Explore-Space/CAD_000/README.md

# 机械设计课程设计

## 设计要求

>（待完善）

## 文件说明

### 主要

>装配图
>
>>装配图A1.dwg
>>
>>装配图A1.bak

>零件图
>
>>大齿轮_A3.dwg
>>
>>大齿轮_A3.bak
>
>>输出轴_A3.dwg
>>
>>输出轴_A3.bak

>设计说明书.docx

### 附件

>（待完善）
