Explore-Space/CAD_000/设计说明书.docx

机械设计课程设计

计算说明书

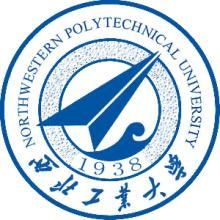
[picture p1: figure]

专业班级： 02031702班

学生姓名： 安宇欣

指导老师： 苏华

目录

一、设计任务

1.1设计题目

设计一个带式输送机传动装置

工作简图如下：

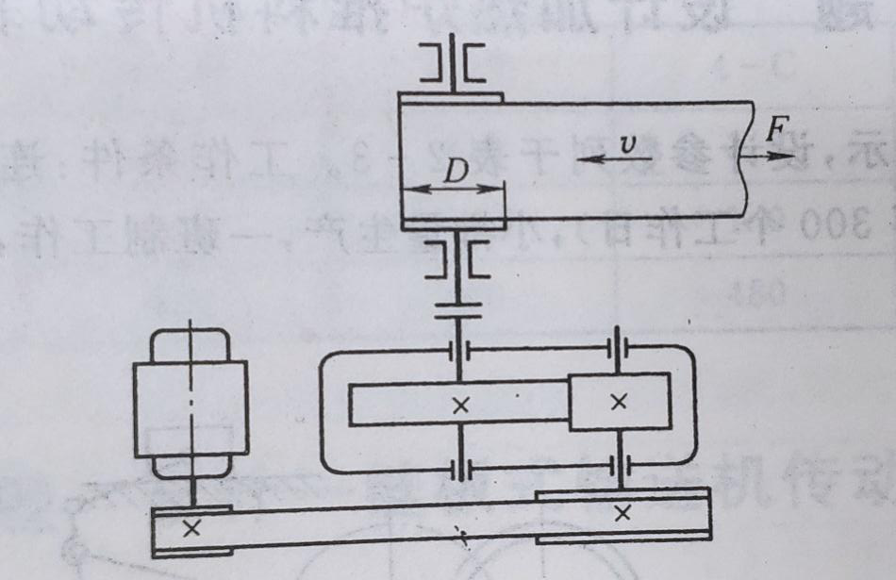
[picture p2: figure]

1.2工作条件

连续单向运转，载荷平稳，空载启动，使用期10年（每年300个工作日），小批量生产，两班制工作，输送机工作轴转速允许误差为±5%。带式输送机的传动效率为0.96。

1.3设计参数

输送带的牵引力为1.5kN，输送带的速度为1.7m/s，输送带滚筒的直径为260 mm。

## 二、电动机选择

2.1 工作机所需功率

P_w =(F_w v_w)/(1000η_w)=1500×1.7/(1000×0.96)=2.6563kW

2.2 电动机至工作机的总效率η

V带传动效率 η_带 =0.96

第一对滚动球轴承效率 η_(轴承1) =0.99

闭式七级精度锥齿轮传动 η_(齿轮) =0.98

第二对滚动球轴承 η_(轴承2) =0.99

联轴器效率 η_(联轴器) =0.99

第三对滚动球轴承 η_(轴承3) =0.99

η=η_带 ×η_(轴承1) ×η_(齿轮) ×η_(轴承2) ×η_(联轴器) ×η_(轴承3) =0.96×0.99×0.97×0.99×0.99×0.99=0.9037

2.3 所需电动机的输出功率 P_d

P_d =P_w /η=2.6563/0.9037=2.9394kW

2.4 电动机的额定功率

由 P_m ≥P_d 选电动机型号，选择电动机型号为Y132S-6，查表得额定功率 P_m =3kW ，满载转速为 n_m =960r/min

根据计算数据参考《机械设计课程设计》第二版P192提供参数，其参数如表1所示

表1
额定功率/kW | 满载转速/（r/min） | 堵转转矩/ 额定转矩 | 最大转矩/ 额定转矩 | 质量/kg
3 | 960 | 2.0 | 2.2 | 63

## 三、传动比分配

总传动比 i=(n_m)/(n_w)=960/124.8754=7.6877

带传动 i_带 =2 ，

则齿轮传动 i_齿 =i/(i_带)=7.6877/2=3.8439

验算工作速度误差 Δv=(v_理 －v_实)/(v_理)×100%=(124.8754-130.8732)/124.8754≤±5%

传动比分配满足要求

即取一级齿轮减速器传动比为3.8439传动比，带传动比为2

## 四、传动参数的计算

4.1各轴的转速

电动机转速： n_m ＝960r/min

减速器输入轴转速： n_1 =(n_m)/(i_带)=960/2=480r/min

减速器输出轴转速： n_2 =(n_1)/(i_齿)=480/3.8439=124.87r/min

链轮轴转速： n_3 ＝n_2 ＝124.87r/min

4.2各轴的输入功率

电动机轴的输入功率: P_0 =P_d =3kW

减速器输入轴功率： P_1 =P_0 ×η_带 =2.88kW

减速器输出轴功率： P_2 =P_1 ×η_(轴承2) ×η_齿 ×η_(轴承3) =2.766×0.99×0.98×0.99=2.766kW

滚筒轴功率： P_3 =P_2 ×η_(联轴器) ×η_(轴承1) =2.766×0.99×0.99=2.711kW

4.3各轴的输入扭矩

电动机输入转矩: T_0 =9550×(P_0)/(n_0)=9550×3/960=29.844N/m

减速器输入轴输入转矩: T_1 =9550×(P_1)/(n_1)=9550×2.88/480=57.3N/m

减速器输出轴输出转矩: T_2 =9550×(P_2)/(n_2)=9550×2.766/124.87=211.542N/m

链板轴输入转矩: T_3 =9550×(P_3)/(n_3)=9550×2.711/124.87=207.336N/m

## 五、V带传动设计计算

5.1选择V带类型

此减速器为轻负载运输机，查《机械设计教程》得其工作情况系数KA=1.1，

故计算功率： P_(ca) =K_A P_m =1.2×3=3.3kW

转速： n_1 =960r/min

根据功率及转速，由《机械设计教程》第三版P74图6.10得：选用A型普通V带。

5.2确定带轮基准直径

由《机械设计教程》第三版P74表6.8、6.9和图6.10得，取小带轮的基准直径为 d_(d1) =100mm 。

则大带轮的基准直径为

d_(d2) =i_d d_(d1) =2×100=200mm

由《机械设计教程》第三版P74表6.9得，取大带轮直径为 d_(d2) =200mm

5.3验算带速

v=(πd_(d1) n_1)/(60×1000)=(π×100×960)/(60×1000)=5.027m/s<30m/s ，略大于5m/s，带速合适。

5.4初定中心距

0.7(d_(d1) +d_(d2) )≤a_0 ≤2(d_(d1) +d_(d2) )

即 210≤a_0 ≤600 ，取 a_0 =400mm 。

5.5确定带的基准长度

L_(d0) =2a_0 +π/2(d_(d1) +d_(d2) )+((d_(d2) -d_(d1) )^2)/(4a_0) =2×400+π/2×(100+200)+((200-100)^2)/(4×400)

=1271.30mm

查表得： L_d =1430mm 。

5.6确定实际中心距

a=a_0 +((L_d -L_(d0) ))/2=400+(1430-1271.30)/2=479.349mm

安装时所需最小中心距：

ad_(min) =a-0.015L_d =457.899mm

张紧或弥补伸长所需最大中心距：

ad_(max) =a+0.015L_d =500.799mm

5.7验算小带轮上的包角 α_1

α_1 =180°-(d_(d2) -d_(d1))/a×57.3°=180°-(200-100)/479.349×57.3°=168.046°

α_1 ≥120° 包角合适。

5.8计算单根V带的基本额定功率

已知 d_(d1) =100mm ， n_1 =960r/min ，查表得， P_0 =0.95kW 。

5.9计算单根V带的额定功率

传动比 i=2 ，查表得 ΔP_0 =0.11kW 。

包角 α_1 =168.046° ，查表得 K_α =0.97 。

带长 L_d =1430mm ，查表得 K_L =0.96 。

计算单根V带的额定功率：

P_r =(P_0 +ΔP_0 )K_L K_α =(0.95+0.11)×0.96×0.97=0.987kW

5.10计算带的根数

z=(P_(ca))/(P_r)=3.3/0.987=3.3434 ，取四根V带。

5.11计算单根V带的初拉力 F_0

由《机械设计教程》，A型V带的单位长度质量q=0.105kg/m。所以单根V带的初拉力F0为

F_0 =500×((2.5-K_α )P_(ca))/(K_α zv)+qv^2 =500×((2.5-0.97)×3.3)/(0.97×4×5.027)+0.105×5.027^2 =132.083N

5.12计算压轴力

其压轴力为：

F_P =2zF_0 sin(α_1)/2=2×4×132.083sin(168.046°)/2=1050.920N

## 六、闭式斜齿圆柱齿轮传动计算

6.1选定齿轮材料、齿数及齿宽系数

6.1.1选择材料如下:

小齿轮材料：40Cr，调质HBS1=250；大齿轮材料：45钢，调质HBS2=210；HBS1-HBS2=40；

6.1.2选齿数

小齿轮齿数选为 z_1 =27 ，大齿轮齿数 z_2 =27×3.8439=103.79 ，圆整为104

实际齿数比3.852，误差0.207%，可用

6.1.3选齿宽系数

由表8.4选定齿宽系数： φ_d =1.0

6.1.4初选螺旋角 β=15°

6.1.5计算几何参数

法面压力角： α_n =20°

tanα_t =(tanα_n)/(cosβ)=(tan20°)/(cos15°)=0.3768, α_t =20.6469°=20°38'49''

sinβ_b =sinβcosα_n =sin15°cos20°=0.2432

β_b =14.0761°=14°4'34''

ε_α =1/(2πcosα_t)[√((z_1 +2cosβ)^2 -(z_1 cosα_t )^2)+√((z_2 +2cosβ)^2 -(z_1 cosα_t )^2)-(z_1 +z_2 )sinα_t =1.631

6.2按齿面接触疲劳强度计算

6.2.1确定计算参数

6.2.1.1由表8.2取载荷系数 K=1.1

6.2.1.2计算转矩 T_1 =9.55×(10^6 P_1)/(n_1)=9.55×10^6 ×2.88/480=5.73×10^4 N·mm

6.2.1.3区域系数 Z_H =√((2cosβ_b)/(sinα_t cosα_t)=)2.4247 。

6.2.1.4对于钢对钢齿轮，弹性影响系数 Z_E =189.8√(MPa) 。

6.2.1.5由表8.6所列公式计算 σ_(Hlim)

小齿轮为合金钢调制， σ_(Hlim1) =1.3×HBS_1 +375=700MPa

大齿轮为碳钢调 σ_(Hlim2) =HBS_2 +350=210+350=560MPa

6.2.1.6计算寿命系数

N_2 =60n_2 jl_h =60×480×(300×2×8×10)/3.8439=3.596×10^8 N_0 =30×(HBS)^2.4 =30×210^2.4 =1.12×10^7

N_2 >N_0 , 取 K_(HN1) =1,K_(HN2) =1

6.2.1.7计算 [σ_H ]

由表8.5，取安全系数 S_H =1.1 。

[σ_H ]_2 =(K_(HN2) σ_(Hlim2))/(S_H)=509.09MPa

6.2.2计算齿轮参数

6.2.2.1由式（8.9）计算 d_1

d_1 ≥³√((2KT_1)/(φ_d)(u+1)/u((Z_H Z_E)/([σ_H ])))^2 =³√((2×1.1×5.73×10^4)/(1×1.631)×(3.852+1)/3.852×((2.4247×189.8)/509.09)^2) =43.006mm

6.2.2.2计算模数m

m≥(d_1)/(z_1)cosβ=43.009/27×cos15°=1.539mm

6.3按齿根弯曲强度设计

6.3.1确定计算参数

6.3.1.1确定复合齿形系数 Y_(FS)

Z_(v1) =(z_1)/((cosβ)^3)=29.959

Z_(v2) =(z_2)/((cosβ)^3)=115.399

由表8.3查得 Y_(FS1) =4.10,Y_(FS2) =3.9062

6.3.1.2计算螺旋角系数

ε_β =bsinβ/(πm_n )=0.318φ_d z_1 tanβ>1 ，取 ε_β =1

γ_β =1-ε_β β/(120°)=1-1×(15°)/(120°)=0.875

6.3.1.3由表8.6所列公式计算 σ_(Flim)

σ_(Flim1) =0.44×HBS_1 +186=0.44×250+186=296MPa σ_(Flim2) =0.23×HBS_2 +166=0.23×210+166=214.3MPa

6.3.1.4计算寿命系数

N_1 =60n_1 jl_h =60×480×(300×2×8×10)=1.3824×10^9

N_2 =60n_2 jl_h =(N_1)/3.852=3.589×10^8

N>N_0 =4×10^6 , 取得 K_(FN1) =1,K_(FN2) =1

6.3.1.5计算 [σ_F ]

由表8.5，选取安全系数 S_F =1.4

[σ_F ]_1 =(K_(FN1) σ_(Flim1))/(S_F)=211.429MPa [σ_F ]_2 =(K_(FN2) σ_(Flim2))/(S_F)=153.071MPa

6.3.2计算齿根疲劳强度

6.3.2.1判定大小轮的弯曲疲劳强度

(Y_(FS1))/([σ_F ]_1)=4.10/211.429=0.0194

(Y_(FS2))/([σ_F ]_2)=3.9062/153.071=0.0255

由 (Y_(FS1))/([σ_F ]_1)<(Y_(FS2))/([σ_F ]_2) ，故按大齿轮计算弯曲疲劳强度

6.3.2.2由式（8.14）计算齿轮的模数

m≥³√((2KT_1 Y_β (cosβ)^2)/(φ_d z_1 ^2 ε_α)(Y_(FS2))/([σ_F ]_2))=³√((2×1.1×0.875×5.73×10^4 ×(cos15°)^2 ×3.9062)/(1×27^2 ×1.631×153.071))=1.302mm

6.4确定模数

综合齿面接触疲劳强度、齿根弯曲疲劳强度确定标准为 m_n =2mm

6.5计算中心距

a=(m_n (z_1 +z_2 ))/(2cosβ)=135.621mm, 圆整为135mm

6.6修正螺旋角 β

β=arcos(m_n (z_1 +z_2 ))/(2a)=13.9823°=13°58'56.32''

修正后的螺旋角略大于初选螺旋角，并且所选模数大于计算模数，无需对结果进行修正

6.7计算齿轮的几何尺寸

m_t =(m_n)/(cosβ)=2/(cos13.9823°)=2.061mm

d_1 =m_t z_1 =2.061×27=55.647mm d_2 =m_t z_2 =2.061×104=214.344mm b_2 =φ_d d_1 =1×55.647mm≈56mm

b_1 =b_2 +(2~3)=58mm v=(πd_1 n_1)/(60×1000)=(π×55.647×480)/(60×1000)=1.399m/s

6.8选择齿轮精度等级

由表8.7及8.8，选择七级精度齿轮。

## 七、减速器箱体结构设计

7.1箱体结构参数确定

名称 | 代号 | 尺寸关系 | 尺寸/mm
箱座壁厚 | δ | 0.025 a_2 +1mm≥8mm | 8
箱盖壁厚 | δ_1 | (0.8~0.85)δ≥8mm | 8
地脚螺栓直径 | d_f | 0.036a+12mm | M20
地脚螺栓数目 | n | a≤250mm,n=4 a>250~500mm,n=6 | 4
箱座凸缘厚度 | b | 1.5δ | 12
箱盖凸缘厚度 | b_1 | 1.5 δ_1 | 12
箱座底凸缘厚度 | b_2 | 2.5δ | 20
轴承旁连接螺栓直径 | d_1 | 0.75 d_f | M16
箱座与箱盖连接螺栓直径 | d_2 | (0.5~0.6) d_f | M10
连接螺栓 d_2 的间距 | l | 150~200mm | 180
轴承盖螺钉直径 | d_3 | (0.4~0.5) d_f | M8
视孔盖螺钉直径 | d_4 | (0.3~0.4) d_f | M6
定位销直径 | d | (0.7~0.8) d_2 | 6
d_f 、d_1 、d_2 至外箱壁距离 | c_1 | 查表 | 18
d_f 、d_2 至凸缘边缘距离 | c_2 | 查表 | 18
轴承旁凸台半径 | R_1 | c_2 | 24
凸台高度 | h | 查图 | 50
外箱壁至轴承座端面距离 | l_1 | c_1 + c_2 +（5~8）mm | 42
大齿轮齿顶圆与内箱壁的距离 | Δ_1 | ≥δ | 8
齿轮端面与内箱壁的距离 | Δ_2 | ≥δ | 8
箱盖肋厚 | m 1 | 0.85 δ_1 | 6.8
箱座肋厚 | m | 0.85 δ_1 | 8
轴承盖外径 | D_2 | 查图 | 112
轴承旁连接螺栓距离 | s | 查图 | 120

## 八、轴的强度校核

8.1低速轴

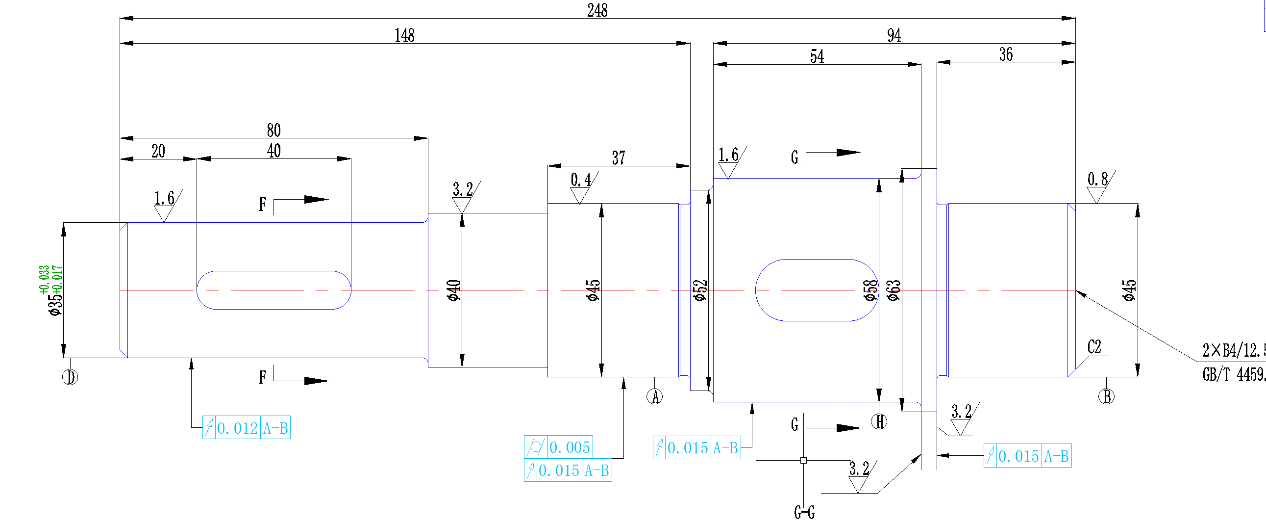
[picture p3: figure]

8.1.1选择轴的材料

选用45钢作为轴的材料，调质处理，取 [τ]=35MPa 8.1.2初算轴径

估算最小轴径： d≧³√((9550000P)/(0.2n[τ]_T))=29.489mm

考虑有键槽，将直径增大 7%，则

d=29.489×1.07=31.55mm ，取35mm

8.1.3联轴器选型

选用凸缘联轴器(摘自GB/T 5843—2003)

型号：GY5, Y型

公称转矩： 400N·m

许用转速： 8000r/min

轴孔直径mm：30, 32, 35, 38

轴孔长度（推荐）mm：82

8.1.4轴上各段长度确定

第一段，半联轴器与轴配合的毂孔长度为80mm，取轴长为80mm，轴孔直径为35mm；

第二段，要对联轴器定位，为了使可靠定位，定位轴肩高度取 h=(0.07~0.1)d ，该段还需要安装密封圈，根据密封圈的标准尺寸，最终取 d_2 =40mm 。经轴承位置等相关尺寸确定，取 L_2 =31mm 。

对于第三段，需要安装轴承，轴承型号为7209AC，取 d_3 =45mm,L_3 =34mm

第四段，需要对甩油环进行定位，为了使其可靠定位，定位轴肩高度 h=(0.07~0.1)d ，最终取 d_4 =52mm ， L_4 =9mm 。

第五段，需要安装大齿轮，取 d_5 =58mm ， L_5 =54mm 。

第六段，需要对大齿轮进行定位，为了使其可靠定位，定位轴肩高度 h=(0.07~0.1)d ，最终取 d_6 =63mm ， L_6 =7mm 。

第七段安装轴承及甩油环，为使大齿轮定位可靠。取 d_7 =45mm ， L_7 =33mm 。

8.2高速轴

8.2.1材料选择

选用40Cr作为轴的材料，调质处理，取 [τ]=35MPa 8.2.2初算轴径

估算最小轴径： d≧³√((9550000P)/(0.2n[τ]_T))=19.0797mm

考虑有键槽，将直径增大 5%，则

d=19.0797×1.07=20.415mm ，取25mm

8.2.3轴上各段长度

第一段，长度应该比大带轮宽度略短一些，取轴长为50mm，轴孔直径为25mm；

第二段，非定位轴肩，轴肩高度取 h=2.5mm ，该段还需要安装密封圈，根据密封圈的标准尺寸，最终取 d_2 =30mm 。经轴承位置等相关尺寸确定，取 L_2 =55mm 。

对于第三段，需要安装轴承及甩油环，轴承型号为7207AC，取 d_3 =35mm,L_3 =32mm

第四段需要对甩油环进行定位，为了使其可靠定位，定位轴肩高度 h=(0.07~0.1)d ，最终取 d_4 =32mm ， L_6 =6mm 。

第五段为齿轮轴部分，按照齿轮部分设计，齿轮分度圆直径为55.65mm,此段长度为58mm。

第六段需要对甩油环进行定位，为了使其可靠定位，定位轴肩高度 h=(0.07~0.1)d ，最终取 d_6 =32mm ， L_6 =6mm 。

第七段安装轴承，轴径为取 d_7 =35mm ， L_7 =33mm 。

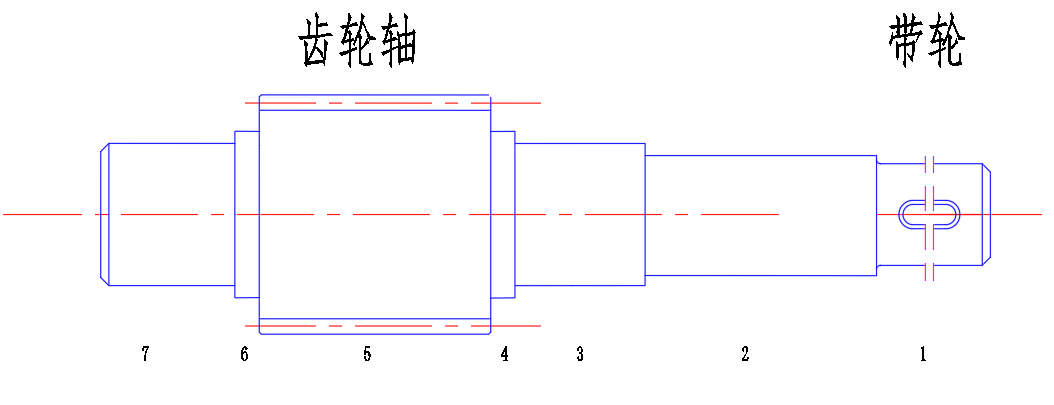
[picture p4: figure]

## 九、轴上其他零件校核

9.1键的强度校核

9.1.1大齿轮轴连接齿轮段，连接齿轮键的尺寸：16×10，长度为32mm

σ_(bs) =(4000T)/(hld)=(4000×211.542)/(10×(32-16)×58)=91.1818MPa<[σ_(bs) ]=135MPa ，符合强度要求

9.1.2连接联轴器段的键尺寸：10×8，长度40mm

σ_(bs) =(4000T)/(hld)=(4000×211.542)/(8×(40-10)×35)=100.7342MPa<[σ_(bs) ]=135MPa ，符合强度要求

9.1.3连接带轮段键的尺寸：8×7，长度22mm

σ_(bs) =(4000T)/(hld)=(4000×57.3)/(7×(22-8)×25)=93.5510MPa<[σ_(bs) ]=135MPa ，符合强度要求

9.2轴承寿命验算

L=(10^6)/(60n)(C/P)^ε

对于角接触球轴承，ε=3

9.2.1对于大齿轮对应轴上轴承，轴承型号7209AC，基本额定动载荷36.8kN

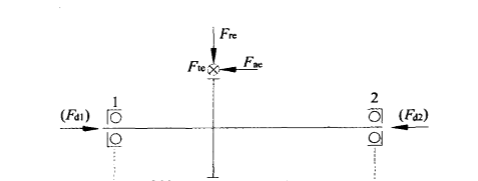
[picture p5: figure]

9.2.1.1确定轴承径向载荷 F_(r1) 、 F_(r2) 和外部轴向力 F_(ae1)

F_(r1) =√(F_(1H)^2 +F_(1V)^2)=√(1067.5^2 +1717.6^2)N=2022.3N

F_(r2) =√(F_(2H)^2 +F_(2V)^2)=√(962.4^2 +327^2)N=1016.4N

F_(ae1) =F_(a1) =916.94N

9.2.1.2求两轴承实际承受的轴向力 F_(a1) 和F_(a2) 。对于7209AC型轴承，查的轴承的派生轴向力 F_d =0.68F_r ，有：

F_(d1) =0.68F_(r1) =0.68*2022.3=1375.16N

F_(d2) =0.68F_(r2) =0.68*1016.4=691.15N

轴承1被压紧，轴承2被放松，得：

F_(a1) =F_(ae) +F_(d1) =840+1375.16=2215.09N

F_(a2) =F_(d2) =691.15 N

9.2.1.3求两轴承的当量动载荷P1和P2。查的e=0.68

(F_(a1))/(F_(r1))=2215/2022.3>0.68

(F_(a2))/(F_(r2))=691.15/1016.4=0.68

当量动载荷系数

X_1 =0.44,Y_1 =1.00 X_2 =1,Y_2 =0

轴平稳运转，取 f_p =1.1

P_1 =f_p (X_1 F_(r1) +Y_1 F_(a1) )=1.1×(0.44×2022.3+1×691.15)=1739.06N

P_2 =f_p (X_2 F_(r2) +Y_2 F_(a2) )=1.1×1016.4=1118.04N

9.2.1.4验算轴承寿命。 P_1 >P_2 ，所以按轴承1的受力大小验算

L_h =(10^6)/(60n)((f_1 C_r)/P)^ε =(10^6)/(60×274.5)((1×36800)/1739.06)^3 =575315.6h

L_h >L_h^(') =20000h ，故7206C 轴承能满足预期计算寿命计算

9.2.2对于齿轮轴上轴承，轴承型号7207AC，基本额定动载荷29kN

9.2.2.1确定轴承径向载荷 F_(r1) 、 F_(r2) 和外部轴向力 F_(ae1)

F_t =(2T)/(d_m)=(2×76.4)/(54.86×10^(-3))=2785.3N

F_r =F_t tan20/cos18.8879=1071.45N

F_a =F_t tan18.8879=953.0N

M_a =(F_a *D)/2=26.14N·m

由 ∑M_H =0 ，求得 F_(H1) =(F_t *L_2)/(L_2 +L_3)=1392.7N

F_(H2) =(F_t *L_3)/(L_2 +L_3)=1392.7N

由 ∑M_x =0 , ∑M_y =0 , ∑F_x =0 , ∑F_y =0 ,求得

求得轴承沿轴向力： F_(a1) =F_a =9534N

轴承沿垂直于轴向力; F_(v1) *（L_2 +L_3 ）=F_r *L_2 +M_a

F_(v1) =(F_r *L_2 -M_a)/(L_2 +L_3)=306.14N

F_(v2) *（L_2 +L_3 ）=F_r *L_3 -M_a

F_(v2) =(F_r *L_3 +M_a)/(L_2 +L_3)=765.3N

F_(r1) =√(F_(1H)^2 +F_(1V)^2)=√(1392.7^2 +306.14^2)N=1425.95N

F_(r2) =√(F_(2H)^2 +F_(2V)^2)=√(1392.7^2 +765.3^2)N=1589.1N

F_(ae1) =F_(a1) =953.0N

9.2.2.2求两轴承实际承受的轴向力 F_(a1) 和F_(a2) 。对于7209AC型轴承，查的轴承的派生轴向力 F_d =0.68F_r ，有：

F_(d1) =0.68F_(r1) =0.68*1425.95=969.6N

F_(d2) =0.68F_(r2) =0.68*1589.1=1080.6N

轴承2被压紧，轴承1被放松，得：

F_(a1) =F_(d1) =969.6N

F_(a2) =F_(ae) +F_(d2) =2033.6 N

9.2.2.3求两轴承的当量动载荷P1和P2。查的e=0.68

(F_(a1))/(F_(r1))=0.68

(F_(a2))/(F_(r2))>0.68

当量动载荷系数

X_1 =1,Y_1 =0 X_2 =0.44,Y_2 =1.00

轴平稳运转，取 f_p =1.1

P_1 =f_p (X_1 F_(r1) +Y_1 F_(a1) )=1.1×1425.95=1568.55N

P_2 =f_p (X_2 F_(r2) +Y_2 F_(a2) )=1.1×(0.44×1589.1+1×2033.6)=3006.1N

9.2.2.4验算轴承寿命。 P_1 >P_2 ，所以按轴承1的受力大小验算

L_h =(10^6)/(60n)((f_1 C_r)/P)^ε =(10^6)/(60×76.4)((1×29000)/3006.1)^3 =195857.0h

L_h >L_h^(') =20000h ，故7206C 轴承能满足预期计算寿命计算

## 十、其他零件设计

10.1轴承端盖

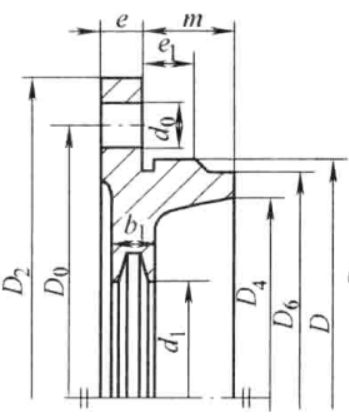
[picture p6: figure]
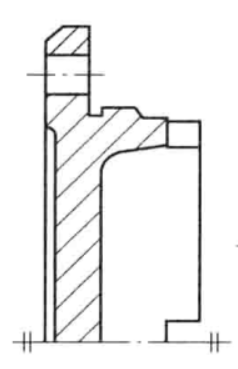
[picture p7: figure]

减速器共使用4个轴承端盖，材料HT250铸造件两个透盖，两个闷盖。

轴承盖参数： 单位：毫米

| 高速轴轴承盖 | 低速轴轴承盖
D | 72 | 85
d_3 | 8 | 8
d_0 | 9 | 9
D_0 | 92 | 105
D_2 | 112 | 125
e | 9.6 | 9.6
e_1 | 9.6 | 9.6
D_4 | 60 | 70
D_5 | 68 | 81
D_6 | 70 | 81

10.2联轴器

根据减速器的输出轴的转矩以及转速，选用LX3联轴器 GB/T 5014—2003。其主要参数如下表

公称转矩/（N·m） | 许用转速/（r/min） | 轴孔直径dz/mm | 轴孔长度/mm | 质量/kg
400 | 8000 | 30,32,35,38 | 82 | 5.43

10.3通气器

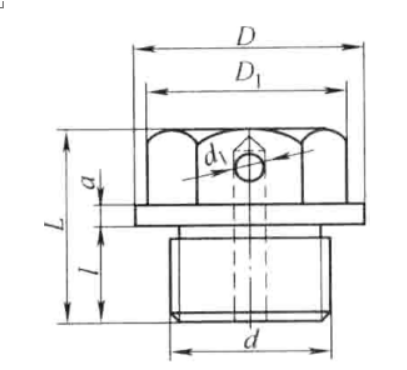
[picture p8: figure]

采用简易式通气器，参数如下：

单位：毫米

符号 | d | D_1 | D | d_1 | L | l | a
参数 | M16×1.5 | 19.6 | 22 | 5 | 23 | 12 | 2

10.4视孔盖

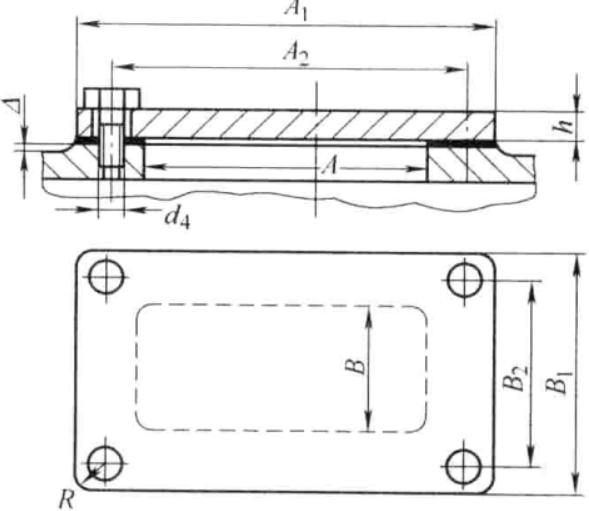
[picture p9: figure]

视孔盖采用轧制钢板制成，它和箱体之间加石棉橡胶密封垫片，以防止漏油，其参数如下：

符号 | A_1 | A_2 | A | B_1 | B_2 | B | h | d_4 | Δ
参数（mm） | 130 | 115 | 100 | 70 | 55 | 40 | 4 | 6 | 2

10.5油标

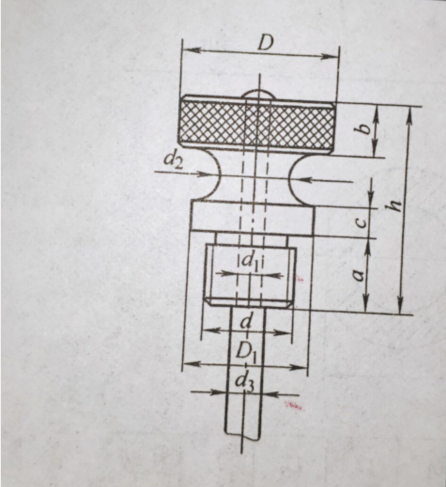
[picture p10: figure]

参数 | d | d_1 | d_2 | d_3 | h | a | b | c | D | D_1
大小 | M20*1.5 | 4 | 16 | 6 | 35 | 12 | 8 | 5 | 26 | 22

10.6油塞

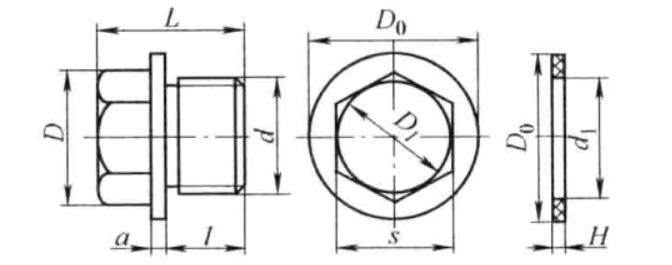
[picture p11: figure]

符号 | d | D_0 | L | l | a | D | s | d_1 | H
参数 | M16×1.5 | 26 | 23 | 12 | 3 | 19.6 | 17 | 17 | 2

10.7吊耳

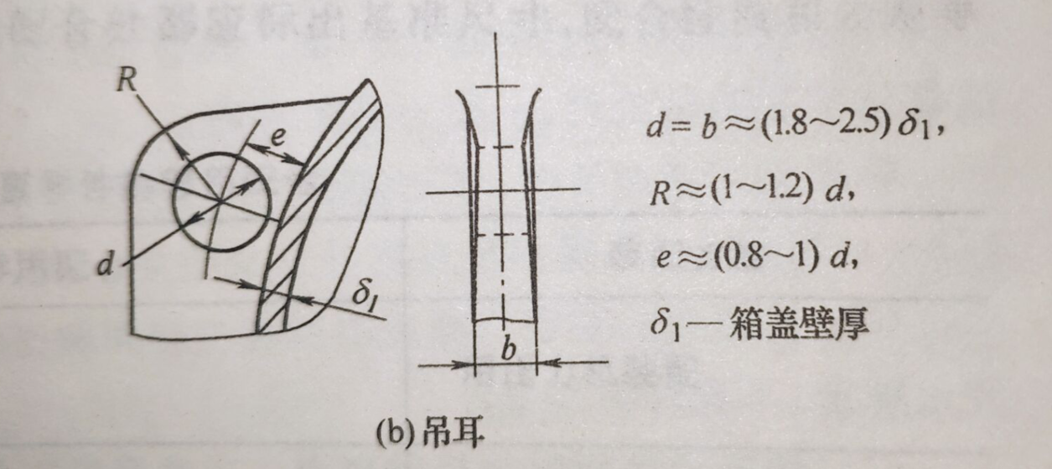
[picture p12: figure]

d | R | e | δ_1
15mm | 18mm | 12mm | 8mm

10.8吊钩

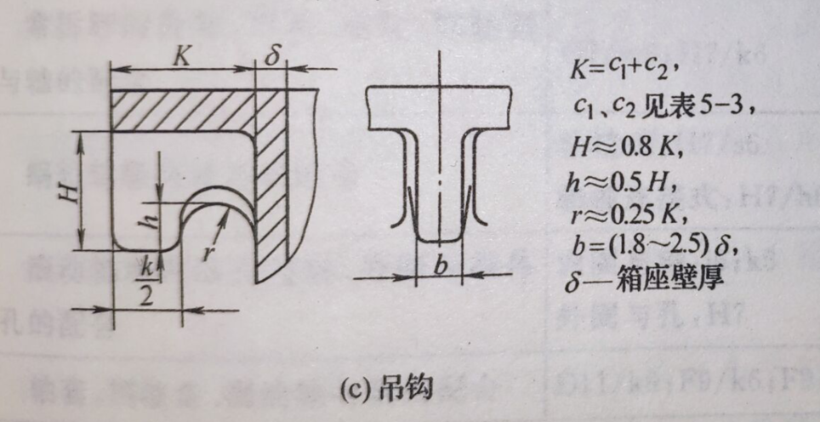
[picture p13: figure]

K | H | h | r | b
34mm | 27.2mm | 13.6mm | 8.5mm | 15mm

## 十一、润滑及密封设计

11.1润滑方式及润滑剂选择

齿轮圆周速度小于v=12m/s，传动零件采用浸油润滑为锥齿轮传动，浸油高度应没过大锥齿轮齿宽，至少应没过1/2齿宽，齿顶距箱底至少22mm, 这里取为25mm。小齿轮转速480r/min，功率3.84kW，减速比小于10，选取粘度为46～68的润滑油，采用全损耗系统润滑油，L-AN68。

同时由于浸油齿轮的圆周速度小于2 m/s，齿轮不能有效的把油飞溅到箱壁上，滚动轴承采用脂润滑。选用 ZL-2 号通用锂基润滑脂（GB 7324-1994）。

11.2密封方式选择及结构设计

轴承室内侧密封用甩油环，防止箱内润滑油进入轴承室而是润滑脂稀释流出。同时也防止轴承室中的润滑脂流入箱内导致油脂混合。

轴承室与外界间的密封，轴承用脂润滑，且轴的最高圆周速度不超过 2m/s，属于低速范畴，使用毡圈油封。

## 十二、设计小结

这次的课程设计让我将以前学习的理论知识进一步的巩固，对许多设计过程有了更加深刻直接的认识，也深深的体会到了一个工程中的机械设计人员的辛苦。在这次课程设计实习过程中，我遇到了许许多多的困难，其中很多时候在做无用功，通过与同学交流与老师沟通，仔细查阅课本后才一一解决。通过这次课程设计，我明白了一个道理，在做一件事情的时候只要你可以全身心的投入进去，在面对困难时不退缩，那么最终一定会收获到自己的想要的结果。

## 十三、参考资料

[1]李育锡，机械设计课程设计，第1版，北京：高等教育出版社，2008.

[2]吴立言，李光磊，机械设计教程，第3版，西安：西北工业大学出版社，2012

[3]孙恒，李继庆，机械原理教程，第2版，西安：西北工业大学出版社，2008
