Explore-Space/CAD_000/打印/A4_设计说明书.pdf

# 机械设计课程设计 计算说明书

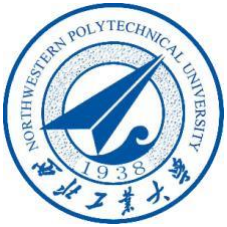
[picture p14: figure]

# 专业班级： 02031702 班

# 学生姓名： 安宇欣

# 指导老师： 苏华

目录

一、设计任务

1.1 设计题目

设计一个带式输送机传动装置

工作简图如下：

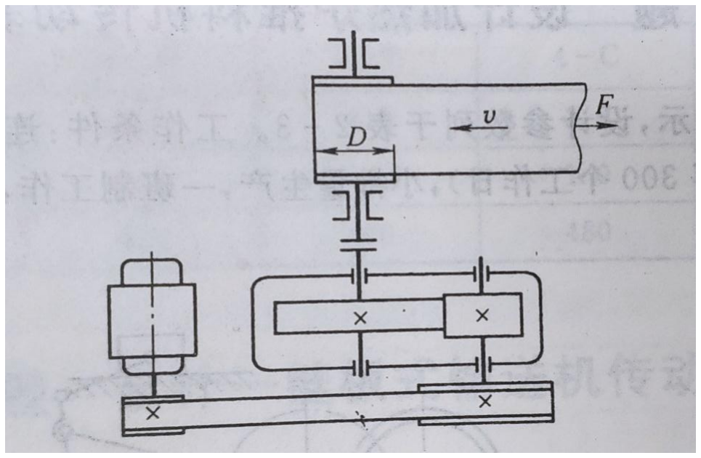
[picture p15: figure]

1.2 工作条件

连续单向运转，载荷平稳，空载启动，使用期 10 年（每年 300 个工作

日），小批量生产，两班制工作，输送机工作轴转速允许误差为±5%。带式输

送机的传动效率为 0.96。

1.3 设计参数

输送带的牵引力为 1.5kN，输送带的速度为 1.7m/s，输送带滚筒的直径为

260 mm。

## 二、电动机选择

2.1 工作机所需功率

Pw =

Fwvw
1000ηw

= 1500 ×

1.7
1000 × 0.96 = 2.6563kW

2.2 电动机至工作机的总效率η

V 带传动效率η带 = 0.96

第一对滚动球轴承效率η轴承 1 = 0.99

闭式七级精度锥齿轮传动η齿轮 = 0.98

第二对滚动球轴承η轴承 2 = 0.99

联轴器效率η联轴器 = 0.99

第三对滚动球轴承η轴承 3 = 0.99

η = η带 × η轴承 1

× η齿轮 × η轴承 2

× η联轴器 × η轴承 3

=0.96 × 0.99 × 0.97 × 0.99

× 0.99 × 0.99=0.9037

2.3 所需电动机的输出功率Pd

Pd = Pw/η = 2.6563/0.9037 = 2.9394kW

2.4 电动机的额定功率

由Pm ≥ Pd选电动机型号，选择电动机型号为 Y132S-6，查表得额定功率

Pm = 3kW，满载转速为nm = 960r/min

根据计算数据参考《机械设计课程设计》第二版 P192 提供参数，其参数如

表 1 所示

表 1

额定功率/kW | 满载转速/ （r/min） | 堵转转矩/ 额定转矩 | 最大转矩/ 额定转矩 | 质量/kg
3 | 960 | 2.0 | 2.2 | 63

## 三、传动比分配

总传动比i =

nm
nw

=

960
124.8754

= 7.6877

带传动i带 = 2，

则齿轮传动i齿 =

i
i带

=

7.6877
2

= 3.8439

验算工作速度误差Δv =

v理－v实

v理

× 100%= ¹²⁴.8754-130.8732
124.8754

≤ ±5%

传动比分配满足要求

即取一级齿轮减速器传动比为 3.8439 传动比，带传动比为 2

## 四、传动参数的计算

4.1 各轴的转速

电动机转速：nm＝960r/min

减速器输入轴转速：n1 =

nm
i带

=

960
2

=480r/min

减速器输出轴转速：n2 =

n1
i齿

=

480
3.8439

=124.87r/min

链轮轴转速：n3＝n2＝124.87r/min

4.2 各轴的输入功率

电动机轴的输入功率:P0 = Pd = 3kW

减速器输入轴功率：P1 = P0 × η带 = 2.88kW

减速器输出轴功率：P2 = P1 × η轴承 2
× η齿

× η轴承 3 = 2.766 × 0.99 × 0.98 ×

0.99=2.766kW

滚筒轴功率：P3 = P2 × η联轴器 × η轴承 1 = 2.766 × 0.99 × 0.99=2.711kW

4.3 各轴的输入扭矩

电动机输入转矩:T0 = 9550 ×

P0
n0

= 9550 ×

3
960

= 29.844N/m

减速器输入轴输入转矩:T1 = 9550 ×

P1
n1

= 9550 ×

2.88
480

= 57.3N/m

减速器输出轴输出转矩:T2 = 9550 ×

P2
n2

= 9550 ×

2.766
124.87

= 211.542N/m

链板轴输入转矩:T3 = 9550 ×

P3
n3

= 9550 ×

2.711
124.87

= 207.336N/m

## 五、V 带传动设计计算

5.1 选择 V 带类型

此减速器为轻负载运输机，查《机械设计教程》得其工作情况系数

KA=1.1，

故计算功率：Pca = KAPm = 1.2 × 3 = 3.3kW

转速：n1 = 960r/min

根据功率及转速，由《机械设计教程》第三版 P74 图 6.10 得：选用 A 型普

通 V 带。

5.2 确定带轮基准直径

由《机械设计教程》第三版 P74 表 6.8、6.9 和图 6.10 得，取小带轮的基准

直径为dd1=100mm。

则大带轮的基准直径为

dd2 = iddd1 = 2 × 100 = 200mm

由《机械设计教程》第三版 P74 表 6.9 得，取大带轮直径为dd2 = 200mm

5.3 验算带速

v =

πdd1n1
60×1000

=

π×100×960
60×1000

= 5.027m/s < 30m/s ，略大于 5m/s，带速合

适。

5.4 初定中心距

0.7(dd1 + dd2

) ≤ a0 ≤ 2(dd1 + dd2

)

即210 ≤ a0 ≤ 600，取a0=400mm。

5.5 确定带的基准长度

Ld0 = 2a0 +

π
2

(dd1 + dd2

) +

(dd2−dd1

)

2

4a0

= 2 × 400 +

π
2

× (100 + 200) +

(200−100)

2

4×400
= 1271.30mm

查表得：Ld = 1430mm。

5.6 确定实际中心距

a = a0 +

(Ld − Ld0

)
2

= 400 +

1430 − 1271.30
2

= 479.349mm

安装时所需最小中心距：

admin = a − 0.015Ld = 457.899mm

张紧或弥补伸长所需最大中心距：

admax = a + 0.015Ld = 500.799mm

5.7 验算小带轮上的包角α1

α1 = 180° −

dd2 − dd1
a

× 57.3° = 180° −

200 − 100
479.349

× 57.3° = 168.046°

α1 ≥ 120°包角合适。

5.8 计算单根 V 带的基本额定功率

已知dd1=100mm，n1 = 960r/min，查表得，P0 = 0.95kW。

5.9 计算单根 V 带的额定功率

传动比i = 2，查表得ΔP0 = 0.11kW。

包角α1 = 168.046°，查表得Kα = 0.97。

带长Ld = 1430mm，查表得KL=0.96。

计算单根 V 带的额定功率：

Pr = (P0 + ΔP0

)KLKα = (0.95 + 0.11) × 0.96 × 0.97 = 0.987kW

5.10 计算带的根数

z =

Pca
Pr

=

3.3
0.987

= 3.3434，取四根 V 带。

5.11 计算单根 V 带的初拉力F0

由《机械设计教程》，A 型 V 带的单位长度质量 q=0.105kg/m。所以单根

V 带的初拉力 F0 为

F0 = 500 ×

(2.5−Kα)Pca
Kαzv

+ qv

2 = 500 ×

(2.5−0.97)×3.3
0.97×4×5.027

+ 0.105 × 5.027² =

132.083N

5.12 计算压轴力

其压轴力为：

FP = 2zF0 sin

α1
2

= 2 × 4 × 132.083 sin

168.046°
2

= 1050.920N

## 六、闭式斜齿圆柱齿轮传动计算

6.1 选定齿轮材料、齿数及齿宽系数

6.1.1 选择材料如下:

小齿轮材料：40Cr，调质 HBS1=250；大齿轮材料：45 钢，调质

HBS2=210；HBS1-HBS2=40；

6.1.2 选齿数

小齿轮齿数选为z1 = 27，大齿轮齿数z2 = 27 × 3.8439 = 103.79，圆整为

104

实际齿数比 3.852，误差 0.207%，可用

6.1.3 选齿宽系数

由表 8.4 选定齿宽系数：φd = 1.0

6.1.4 初选螺旋角β = 15°

6.1.5 计算几何参数

法面压力角：αn = 20°

tanαt =

tanαn
cosβ =

tan20°
cos15° = 0.3768, αt = 20.6469° = 20°38′49′′

sinβb = sinβcosαn = sin15°cos20° = 0.2432

βb = 14.0761° = 14°4′34′′

εα =

1
2πcosαt

[√(z1 + 2cosβ)
2 − (z1cosαt
)

2 + √(z2 + 2cosβ)
2 − (z1cosαt
)

2

− (z1 + z2

)sinαt = 1.631

6.2 按齿面接触疲劳强度计算

6.2.1 确定计算参数

6.2.1.1 由表 8.2 取载荷系数K = 1.1

6.2.1.2 计算转矩T1 = 9.55 ×

10

6P1

n1

= 9.55 × 10

6 ×

2.88
480

= 5.73 × 10⁴N · mm

6.2.1.3 区域系数ZH = √
2cosβb
sinαtcosαt

= 2.4247。

6.2.1.4 对于钢对钢齿轮，弹性影响系数ZE = 189.8√MPa。

6.2.1.5 由表 8.6 所列公式计算σHlim

小齿轮为合金钢调制，σH lim 1 = 1.3 × HBS1 + 375 = 700MPa

大齿轮为碳钢调σH lim 2 = HBS2 + 350 = 210 + 350 = 560MPa

6.2.1.6 计算寿命系数

N2 = 60n2jl

ℎ = 60 × 480 × (300 × 2 × 8 × 10)/3.8439 = 3.596 × 10

8

N0 = 30 × (HBS)

2.4 = 30 × 210

2.4 = 1.12 × 10

7

N2 > N0,取KHN1 = 1, KHN2 = 1

6.2.1.7 计算[σH]

由表 8.5，取安全系数SH = 1.1。

[σH]2 =

KHN2σH lim 2
SH

= 509.09MPa

6.2.2 计算齿轮参数

6.2.2.1 由式（8.9）计算d1

d1 ≥ √
2KT1
φd

u + 1
u

(

ZHZE
[σH]

3
)

2

= √
2 × 1.1 × 5.73 × 10

4
1 × 1.631

×

3.852 + 1
3.852 × (

2.4247 × 189.8
509.09 )

2

3

= 43.006mm

6.2.2.2 计算模数 m

m ≥

d1
z1

cosβ =

43.009
27

× cos15° = 1.539mm

6.3 按齿根弯曲强度设计

6.3.1 确定计算参数

6.3.1.1 确定复合齿形系数YFS

Zv1 =

z1
(cosβ)

3 = 29.959

Zv2 =

z2
(cosβ)

3 = 115.399

由表 8.3 查得YFS1 = 4.10, YFS2 = 3.9062

6.3.1.2 计算螺旋角系数

εβ = b sin β /(πmn) = 0.318φdz1 tan β > 1，取εβ = 1

γβ = 1 − εβ

β
120° = 1 − 1 ×

15°
120° = 0.875

6.3.1.3 由表 8.6 所列公式计算σFlim

σF lim 1 = 0.44 × HBS1 + 186 = 0.44 × 250 + 186 = 296MPa

σF lim 2 = 0.23 × HBS2 + 166 = 0.23 × 210 + 166 = 214.3MPa

6.3.1.4 计算寿命系数

N1 = 60n1jl

ℎ = 60 × 480 × (300 × 2 × 8 × 10) = 1.3824 × 10

9

N2 = 60n2jl

ℎ =

N1
3.852 = 3.589 × 10

8

N > N0 = 4 × 10

6
,取得KFN1 = 1,KFN2 = 1

6.3.1.5 计算[σF

]

由表 8.5，选取安全系数SF = 1.4

[σF

]1 =

KFN1σF lim 1
SF

= 211.429MPa

[σF

]2 =

KFN2σF lim 2
SF

= 153.071MPa

6.3.2 计算齿根疲劳强度

6.3.2.1 判定大小轮的弯曲疲劳强度

YFS1
[σF

]1

=

4.10
211.429 = 0.0194

YFS2
[σF

]2

=

3.9062
153.071 = 0.0255

由

YFS1
[σF]1

<

YFS2
[σF]2

，故按大齿轮计算弯曲疲劳强度

6.3.2.2 由式（8.14）计算齿轮的模数

m ≥ √
2KT1Yβ(cosβ)

2
φdz1

2εα

YFS2
[σF

]2

3

=

√
2 × 1.1 × 0.875 × 5.73 × 10

4 × (cos15°)

2
× 3.9062
1 × 27² × 1.631 × 153.071

3

= 1.302mm

6.4 确定模数

综合齿面接触疲劳强度、齿根弯曲疲劳强度确定标准为mn = 2mm

6.5 计算中心距

a =

mn(z1+z2

)
2cosβ = 135.621mm,圆整为 135mm

6.6 修正螺旋角β

β = arcos

mn

(z1 + z2

)
2a

= 13.9823° = 13°58′56.32′′

修正后的螺旋角略大于初选螺旋角，并且所选模数大于计算模数，无需对

结果进行修正

6.7 计算齿轮的几何尺寸

mt =

mn
cosβ =

2
cos 13.9823° = 2.061mm

d1 = mtz1 = 2.061 × 27 = 55.647mm

d2 = mtz2 = 2.061 × 104 = 214.344mm

b2 = φdd1 = 1 × 55.647mm ≈ 56mm

b1 = b2 + (2~3) = 58mm

v =

πd1n1
60 × 1000 =

π × 55.647 × 480
60 × 1000 = 1.399m/s

6.8 选择齿轮精度等级

由表 8.7 及 8.8，选择七级精度齿轮。

## 七、减速器箱体结构设计

7.1 箱体结构参数确定

名称 | 代号 | 尺寸关系 | 尺寸/mm
箱座壁厚 | δ | 0.025a2+1mm≥8mm | 8
箱盖壁厚 | δ1 | (0.8~0.85)δ≥8mm | 8
地脚螺栓直径 | df | 0.036a+12mm | M20
地脚螺栓数目 | n | a≤250mm,n=4 a>250~500mm,n=6 | 4
箱座凸缘厚度 | b | 1.5δ | 12
箱盖凸缘厚度 | b1 | 1.5δ1 | 12
箱座底凸缘厚度 | b2 | 2.5δ | 20
轴承旁连接螺栓直径 | d1 | 0.75df | M16
箱座与箱盖连接螺栓 直径 | d2 | (0.5~0.6)df | M10
连接螺栓 d2的间距 | l | 150~200mm | 180
轴承盖螺钉直径 | d3 | (0.4~0.5)df | M8
视孔盖螺钉直径 | d4 | (0.3~0.4)df | M6
定位销直径 | d | (0.7~0.8)d2 | 6
df、d1、d2至外箱壁 距离 | c1 | 查表 | 18
df、d2至凸缘边缘距 离 | c2 | 查表 | 18
轴承旁凸台半径 | R1 | c2 | 24
凸台高度 | ℎ | 查图 | 50

外箱壁至轴承座端面 距离 | l1 | c1+c2+（5~8）mm | 42
大齿轮齿顶圆与内箱 壁的距离 | Δ1 | ≥δ | 8
齿轮端面与内箱壁的 距离 | Δ2 | ≥δ | 8
箱盖肋厚 | m1 | 0.85δ1 | 6.8
箱座肋厚 | m | 0.85δ1 | 8
轴承盖外径 | D2 | 查图 | 112
轴承旁连接螺栓距离 | s | 查图 | 120

## 八、轴的强度校核

8.1 低速轴


8.1.1 选择轴的材料

选用 45 钢作为轴的材料，调质处理，取[τ]=35MPa

8.1.2 初算轴径

估算最小轴径：d ≧ √
9550000P
0.2n[τ]T

3
= 29.489mm

考虑有键槽，将直径增大 7%，则 d = 29.489 × 1.07 = 31.55mm，取 35mm

8.1.3 联轴器选型

选用凸缘联轴器(摘自 GB/T 5843—2003)

型号：GY5, Y 型

公称转矩：400N · m

许用转速：8000r/min

轴孔直径 mm：30, 32, 35, 38

轴孔长度（推荐）mm：82

8.1.4 轴上各段长度确定

第一段，半联轴器与轴配合的毂孔长度为 80mm，取轴长为 80mm，轴孔直

径为 35mm；

第二段，要对联轴器定位，为了使可靠定位，定位轴肩高度取ℎ =

(0.07~0.1)d，该段还需要安装密封圈，根据密封圈的标准尺寸，最终取d2 =

40mm。经轴承位置等相关尺寸确定，取L2 = 31mm。

对于第三段，需要安装轴承，轴承型号为 7209AC，取d3 = 45mm, L3 =

34mm

第四段，需要对甩油环进行定位，为了使其可靠定位，定位轴肩高度ℎ =

(0.07~0.1)d，最终取d4 = 52mm，L4 = 9mm。

第五段，需要安装大齿轮，取d5 = 58mm，L5 = 54mm。

第六段，需要对大齿轮进行定位，为了使其可靠定位，定位轴肩高度ℎ =

(0.07~0.1)d，最终取d6 = 63mm，L6 = 7mm。

第七段安装轴承及甩油环，为使大齿轮定位可靠。取d7 = 45mm，L7 =

33mm 。

8.2 高速轴

8.2.1 材料选择

选用 40Cr 作为轴的材料，调质处理，取[τ]=35MPa

8.2.2 初算轴径

估算最小轴径：d ≧ √
9550000P
0.2n[τ]T

3
= 19.0797mm

考虑有键槽，将直径增大 5%，则

d = 19.0797 × 1.07 = 20.415mm，取 25mm

8.2.3 轴上各段长度

第一段，长度应该比大带轮宽度略短一些，取轴长为 50mm，轴孔直径为

25mm；

第二段，非定位轴肩，轴肩高度取ℎ = 2.5mm，该段还需要安装密封圈，

根据密封圈的标准尺寸，最终取d2 = 30mm。经轴承位置等相关尺寸确定，取

L2 = 55mm。

对于第三段，需要安装轴承及甩油环，轴承型号为 7207AC，取d3 =

35mm, L3 = 32mm

第四段需要对甩油环进行定位，为了使其可靠定位，定位轴肩高度ℎ =

(0.07~0.1)d，最终取d4 = 32mm，L6 = 6mm。

第五段为齿轮轴部分，按照齿轮部分设计，齿轮分度圆直径为 55.65mm,此

段长度为 58mm。

第六段需要对甩油环进行定位，为了使其可靠定位，定位轴肩高度ℎ =

(0.07~0.1)d，最终取d6 = 32mm，L6 = 6mm。

第七段安装轴承，轴径为取d7 = 35mm，L7 = 33mm。


## 九、轴上其他零件校核

9.1 键的强度校核

9.1.1 大齿轮轴连接齿轮段，连接齿轮键的尺寸：16×10，长度为 32mm

σbs =

4000T
ℎld

=

4000×211.542
10×(32−16)×58

= 91.1818MPa < [σbs] = 135MPa，符合强度要

求

9.1.2 连接联轴器段的键尺寸：10×8，长度 40mm

σbs =

4000T
ℎld

=

4000×211.542
8×(40−10)×35

= 100.7342MPa < [σbs] = 135MPa，符合强度要

求

9.1.3 连接带轮段键的尺寸：8×7，长度 22mm

σbs =

4000T
ℎld

=

4000×57.3
7×(22−8)×25

= 93.5510MPa < [σbs] = 135MPa，符合强度要

求

9.2 轴承寿命验算

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
对于角接触球轴承，ε=3

9.2.1 对于大齿轮对应轴上轴承，轴承型号 7209AC，基本额定动载荷 36.8kN

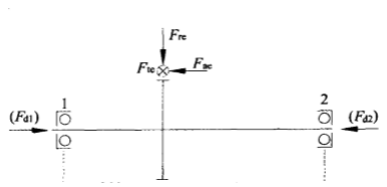
[picture p16: figure]

9.2.1.1 确定轴承径向载荷Fr1、Fr2和外部轴向力Fae1

Fr1 = √F1H
2 + F1V

2 = √1067.5
2 + 1717.6

2N = 2022.3N

Fr2 = √F2H
2 + F2V

2 = √962.4
2 + 327²N = 1016.4N

Fae1 = Fa1 = 916.94N

9.2.1.2 求两轴承实际承受的轴向力Fa1和Fa2。对于 7209AC 型轴承，查的轴承的

派生轴向力Fd = 0.68Fr，有：

Fd1 = 0.68Fr1 = 0.68 ∗ 2022.3 = 1375.16N

Fd2 = 0.68Fr2 = 0.68 ∗ 1016.4 = 691.15N

轴承 1 被压紧，轴承 2 被放松，得：

Fa1 = Fae + Fd1 = 840 + 1375.16 = 2215.09N

Fa2 = Fd2 = 691.15N

9.2.1.3 求两轴承的当量动载荷 P1 和 P2。查的 e=0.68

Fa1

Fr1

=

2215
2022.3

> 0.68

Fa2

Fr2

=

691.15
1016.4

= 0.68

当量动载荷系数

X1 = 0.44, Y1 = 1.00 X2 = 1, Y2 = 0

轴平稳运转，取fp = 1.1

P1 = fp(X1 Fr1 + Y1Fa1) = 1.1 × (0.44 × 2022.3 + 1 × 691.15) = 1739.06N

P2 = fp(X2 Fr2 + Y2Fa2) = 1.1 × 1016.4 = 1118.04N

9.2.1.4 验算轴承寿命。P1 > P2，所以按轴承 1 的受力大小验算

Lℎ =

10

6

60n

(

f1Cr
P

)

ε =

10

6

60×274.5

(

1×36800
1739.06

)

3 = 575315.6ℎ

Lℎ > L
ℎ

′ = 20000ℎ，故 7206C 轴承能满足预期计算寿命计算

9.2.2 对于齿轮轴上轴承，轴承型号 7207AC，基本额定动载荷 29kN

9.2.2.1 确定轴承径向载荷Fr1、Fr2和外部轴向力Fae1

Ft =

2T
dm

=

2 × 76.4
54.86 × 10⁻³ = 2785.3N

Fr = Ft

tan20/cos18.8879 = 1071.45N

Fa = Ft

tan18.8879 = 953.0N

Ma =

Fa ∗ D
2

= 26.14N · m

由∑MH = 0，求得 | FH1 = Ft∗L2 L2+L3 = 1392.7N
| FH2 = Ft ∗ L3 L2 + L3 = 1392.7N

由∑Mx = 0, ∑My = 0, ∑Fx = 0, ∑Fy = 0,求得

求得轴承沿轴向力： | Fa1 = Fa = 9534N
轴承沿垂直于轴向力; | Fv1 ∗ (L2 + L3 ) = Fr ∗ L2 + Ma
| Fv1 = Fr ∗ L2 − Ma L2 + L3
= 306.14N
| Fv2 ∗ (L2 + L3 ) = Fr ∗ L3 − Ma
| Fv2 = Fr ∗ L3 + Ma L2 + L3
= 765.3N

Fr1 = √F1H
2 + F1V

2 = √1392.7
2 + 306.14²N = 1425.95N

Fr2 = √F2H
2 + F2V

2 = √1392.7
2 + 765.3

2N = 1589.1N

Fae1 = Fa1 = 953.0N

9.2.2.2 求两轴承实际承受的轴向力Fa1和Fa2。对于 7209AC 型轴承，查的轴承的

派生轴向力Fd = 0.68Fr，有：

Fd1 = 0.68Fr1 = 0.68 ∗ 1425.95 = 969.6N

Fd2 = 0.68Fr2 = 0.68 ∗ 1589.1 = 1080.6N

轴承 2 被压紧，轴承 1 被放松，得：

Fa1 = Fd1 = 969.6N

Fa2 = Fae + Fd2 = 2033.6N

9.2.2.3 求两轴承的当量动载荷 P1 和 P2。查的 e=0.68

Fa1

Fr1

= 0.68

Fa2

Fr2

> 0.68

当量动载荷系数

X1 = 1, Y1 = 0 X2 = 0.44, Y2 = 1.00

轴平稳运转，取fp = 1.1

P1 = fp(X1 Fr1 + Y1Fa1) = 1.1 × 1425.95 = 1568.55N

P2 = fp(X2 Fr2 + Y2Fa2) = 1.1 × (0.44 × 1589.1 + 1 × 2033.6) = 3006.1N

9.2.2.4 验算轴承寿命。P1 > P2，所以按轴承 1 的受力大小验算

Lℎ =

10

6

60n

(

f1Cr
P

)

ε =

10

6

60×76.4

(

1×29000
3006.1

)

3 = 195857.0ℎ

Lℎ > L
ℎ

′ = 20000ℎ，故 7206C 轴承能满足预期计算寿命计算

## 十、其他零件设计

10.1 轴承端盖

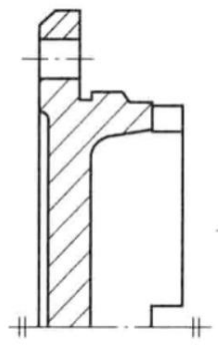
[picture p17: figure]
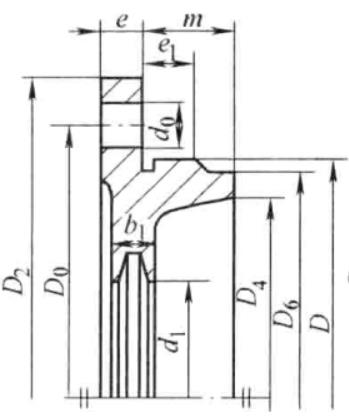
[picture p18: figure]

减速器共使用 4 个轴承端盖，材料 HT250 铸造件两个透盖，两个闷盖。

轴承盖参数： | 单位：毫米
| 高速轴轴承盖 | 低速轴轴承盖
D | 72 | 85
d3 | 8 | 8
d0 | 9 | 9
D0 | 92 | 105
D2 | 112 | 125
e | 9.6 | 9.6
e1 | 9.6 | 9.6
D4 | 60 | 70
D5 | 68 | 81
D6 | 70 | 81

10.2 联轴器

根据减速器的输出轴的转矩以及转速，选用 LX3 联轴器 GB/T 5014—

2003。其主要参数如下表

公称转矩/ （N·m） | 许用转速/ （r/min） | 轴孔直径 dz/mm | 轴孔长度 /mm | 质量/kg
400 | 8000 | 30,32,35,38 | 82 | 5.43

10.3 通气器

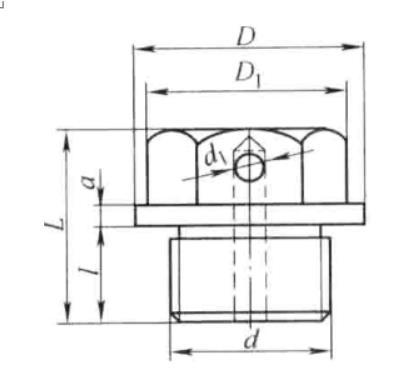
[picture p19: figure]

采用简易式通气器，参数如下：

单位：毫米

符号 | d | D1 | D | d1 | L | l | a
参数 | M16×1.5 | 19.6 | 22 | 5 | 23 | 12 | 2

10.4 视孔盖

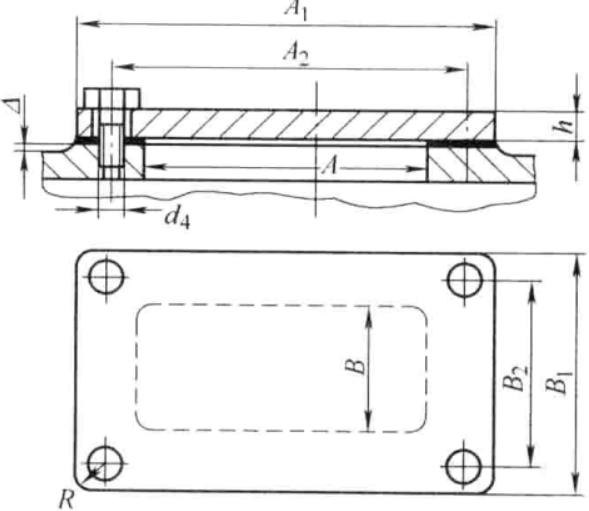
[picture p20: figure]

视孔盖采用轧制钢板制成，它和箱体之间加石棉橡胶密封垫片，以防止漏油，

其参数如下：

符号 | A1 | A2 | A | B1 | B2 | B | ℎ | d4 | Δ
参数 （mm） | 130 | 115 | 100 | 70 | 55 | 40 | 4 | 6 | 2

10.5 油标

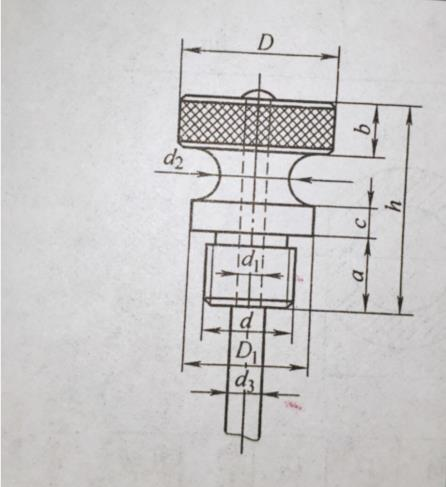
[picture p21: figure]

参数 | d | d1 | d2 | d3 | h | a | b | c | D | D1
大小 | M20*1.5 | 4 | 16 | 6 | 35 | 12 | 8 | 5 | 26 | 22

10.6 油塞

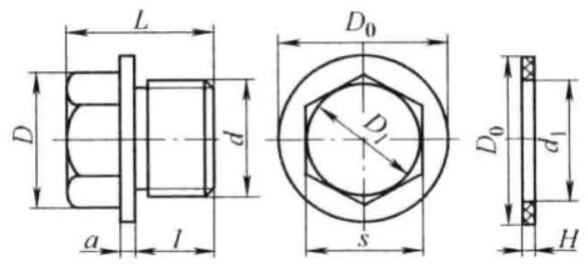
[picture p22: figure]

符号 | d | D0 | L | l | a | D | s | d1 | H
参数 | M16×1.5 | 26 | 23 | 12 | 3 | 19.6 | 17 | 17 | 2

10.7 吊耳

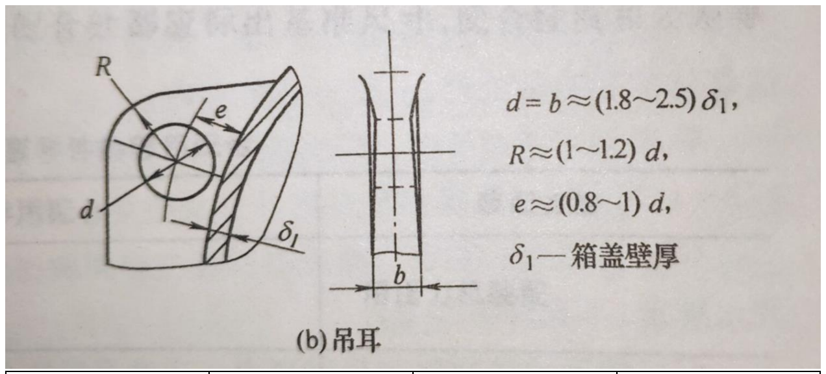
[picture p23: figure]

d | R | e | δ1
15mm | 18mm | 12mm | 8mm

10.8 吊钩

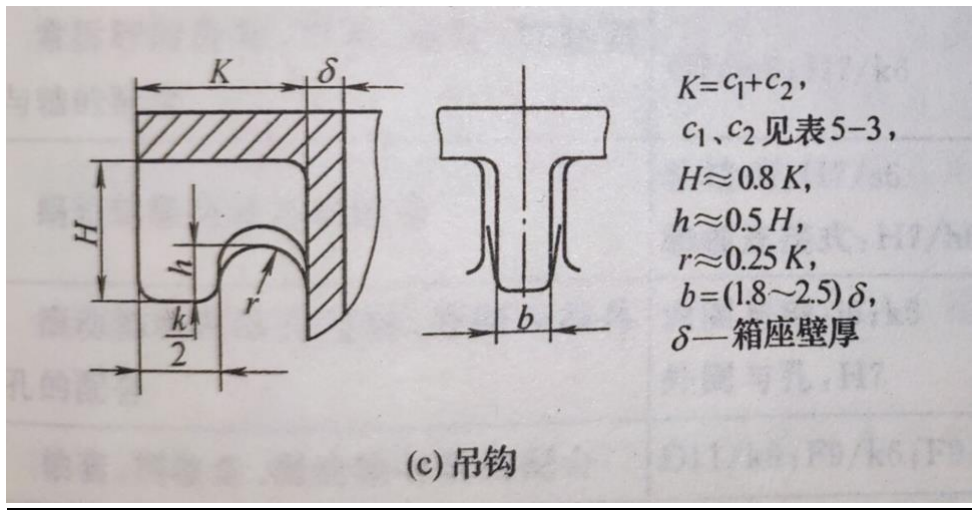
[picture p24: figure]

K | H | h | r | b
34mm | 27.2mm | 13.6mm | 8.5mm | 15mm

## 十一、润滑及密封设计

11.1 润滑方式及润滑剂选择

齿轮圆周速度小于 v=12m/s，传动零件采用浸油润滑为锥齿轮传动，浸油

高度应没过大锥齿轮齿宽，至少应没过 1/2 齿宽，齿顶距箱底至少 22mm, 这里

取为 25mm。小齿轮转速 480r/min，功率 3.84kW，减速比小于 10，选取粘度为

46～68 的润滑油，采用全损耗系统润滑油，L-AN68。

同时由于浸油齿轮的圆周速度小于 2 m/s，齿轮不能有效的把油飞溅到箱壁

上，滚动轴承采用脂润滑。选用 ZL-2 号通用锂基润滑脂（GB 7324-1994）。

11.2 密封方式选择及结构设计

轴承室内侧密封用甩油环，防止箱内润滑油进入轴承室而是润滑脂稀释流

出。同时也防止轴承室中的润滑脂流入箱内导致油脂混合。

轴承室与外界间的密封，轴承用脂润滑，且轴的最高圆周速度不超过

2m/s，属于低速范畴，使用毡圈油封。

## 十二、设计小结

这次的课程设计让我将以前学习的理论知识进一步的巩固，对许多设计过程

有了更加深刻直接的认识，也深深的体会到了一个工程中的机械设计人员的辛苦。

在这次课程设计实习过程中，我遇到了许许多多的困难，其中很多时候在做无用

功，通过与同学交流与老师沟通，仔细查阅课本后才一一解决。通过这次课程设

计，我明白了一个道理，在做一件事情的时候只要你可以全身心的投入进去，在

面对困难时不退缩，那么最终一定会收获到自己的想要的结果。

## 十三、参考资料

[1]李育锡，机械设计课程设计，第 1 版，北京：高等教育出版社，2008.

[2]吴立言，李光磊，机械设计教程，第 3 版，西安：西北工业大学出版社，

2012

[3]孙恒，李继庆，机械原理教程，第 2 版，西安：西北工业大学出版社，2008
