Explore-Space/CAD_000/(list of files, cad)

Other CAD files:
装配图 - 打印/装配图_A1.dwg
装配图/装配图_A1.dwg
零件图/输出轴_A3.dwg
零件图/大齿轮_A3.dwg
装配图 - 副本/装配图_A1.dwg
