Explore-Space/CAD_000/打印/A1_装配图.pdf

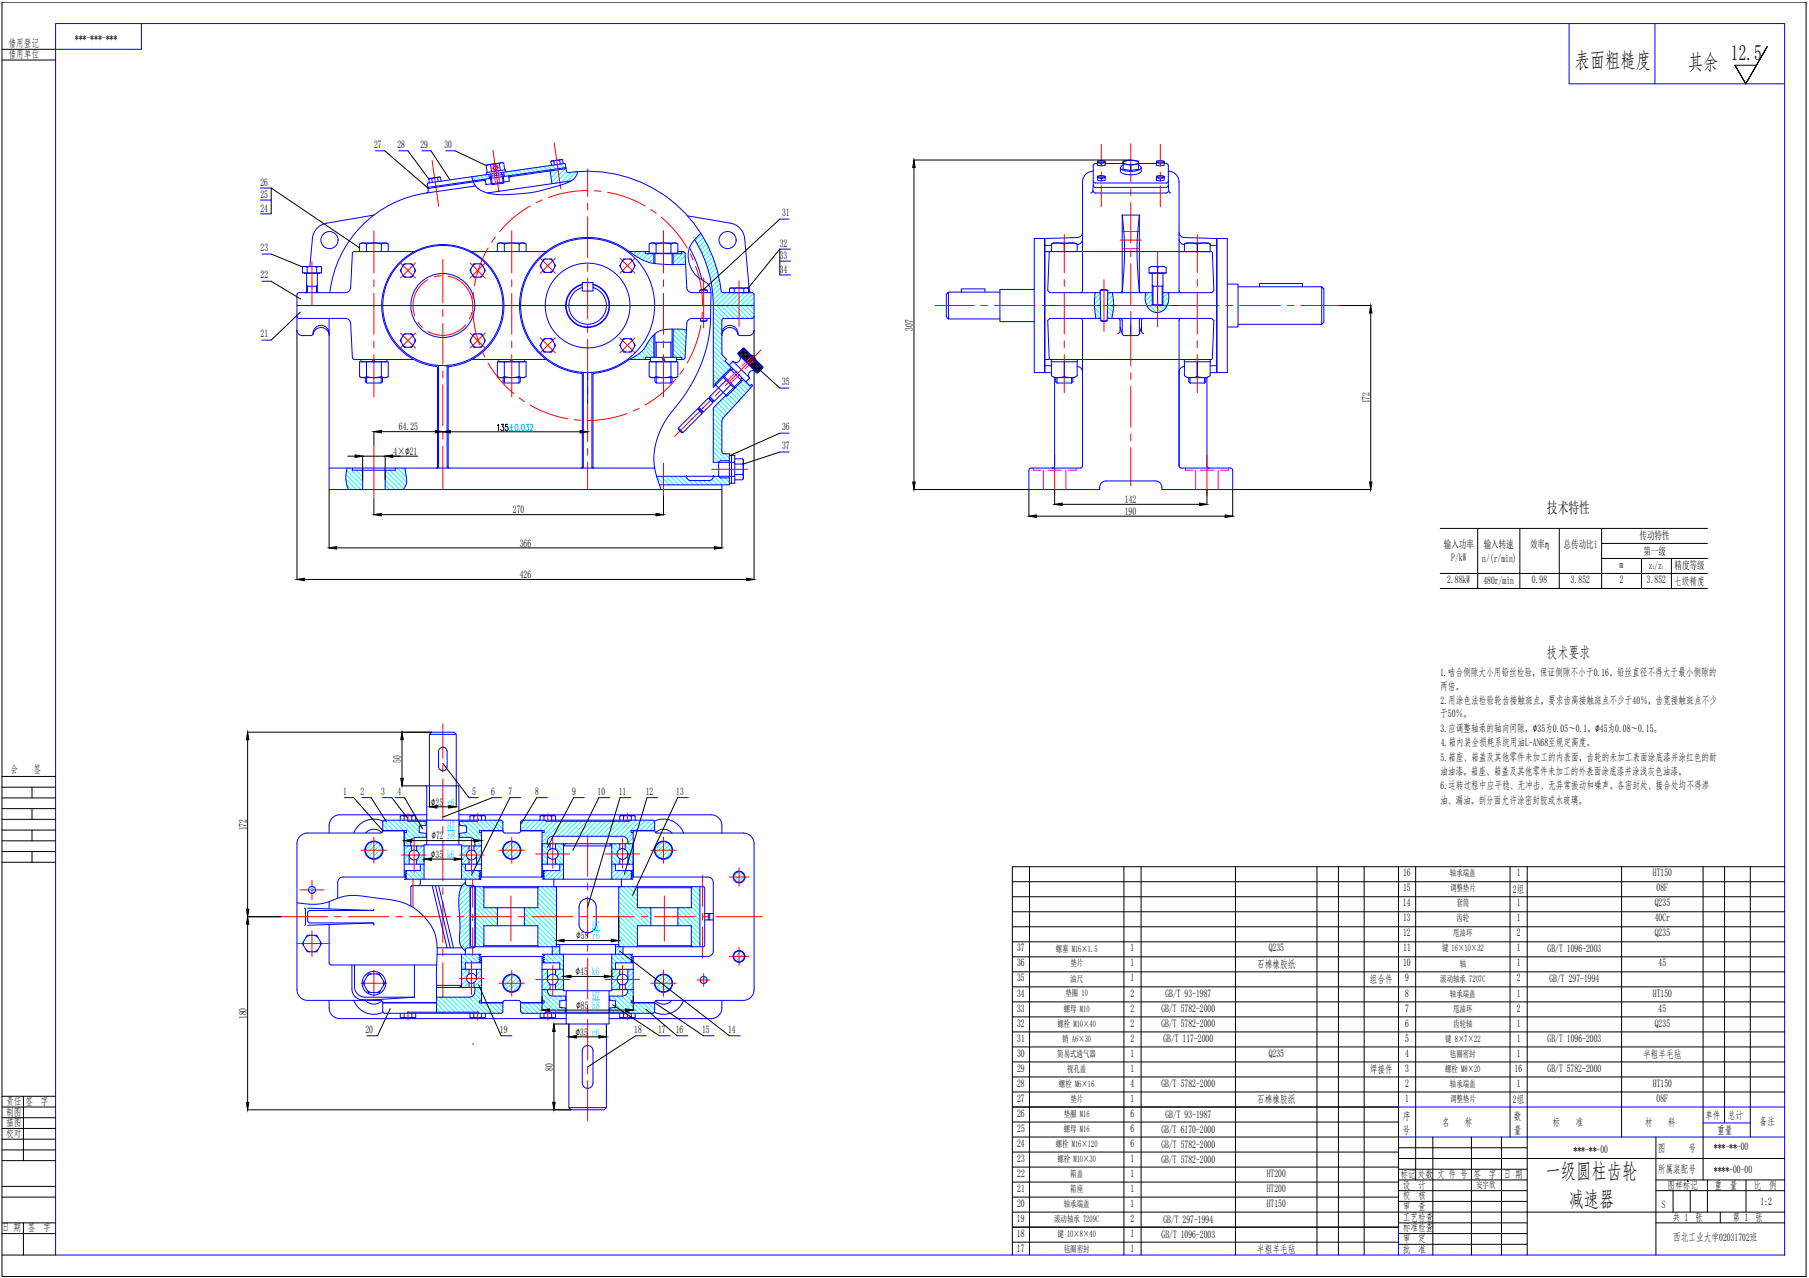
[picture p25: page 1]
借用登记 借用单位 日 期; 签 字 签 字 校对制图描图责任会; 表面粗糙度; 数量 处数 工艺检查 标准检查 审 查 审 定 批 准 设 计 校 核 标记; 西北工业大学02031702班 S 共; 张 1 所属装配号 图样标记; 一级圆柱齿轮 减速器 2; ***-**-00 ****-00-00 1.啮合侧隙大小用铅丝检验，保证侧隙不小于0.16。铅丝直径不得大于最小侧隙的 两倍。 2.用涂色法检验轮齿接触斑点，要求齿高接触斑点不少于40％，齿宽接触斑点不少 于50％。 3.应调整轴承的轴向间隙，∅35为0.05～0.1，∅45为0.08～0.15。 4.箱内装全损耗系统用油L-AN68至规定高度。 5.箱座、箱盖及其他零件未加工的内表面，齿轮的未加工表面涂底漆并涂红色的耐 油油漆。箱座、箱盖及其他零件未加工的外表面涂底漆并涂浅灰色油漆。 6.运转过程中应平稳、无冲击、无异常振动和噪声。各密封处、接合处均不得渗 油、漏油。剖分面允许涂密封胶或水玻璃。 技术特性 输入功率 P/kW; 输入转速 n/(r/min); 效率η; 总传动比i; 传动特性 第一级 m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

80 1 2 3 4 5 6 7 8 9 10 11 12 13 20 19 18 17 16 15 14 212223242526 27 28 29 30 34333231353637 1 28 4 2930313233343536371920 1 2122232425262718 12 调整垫片 轴承端盖 螺栓 M8×20 毡圈密封 键 8×7×22 齿轮轴 甩油环 轴承端盖 滚动轴承 7207C 轴 键 16×10×32 甩油环 齿轮套筒 调整垫片 轴承端盖 毡圈密封 键 10×8×40 滚动轴承 7209C 轴承端盖 箱座箱盖 螺栓 M10×30 螺栓 M16×120 螺母 M16 垫圈 M16 垫片 螺栓 M6×16 视孔盖 简易式通气器 销 A6×30 螺栓 M10×40 螺母 M10 垫圈 10 油尺垫片 螺塞 M16×1.5 17 16111212112112组1 1111666211222111 半粗羊毛毡 Q235 45 40Cr 08F HT150 HT150 HT200 HT200 石棉橡胶纸 石棉橡胶纸 GB/T 5782-2000 GB/T 1096-2003 45 Q235 HT150 HT150 GB/T 297-1994 GB/T 1096-2003 GB/T 1096-2003 GB/T 297-1994 GB/T 5782-2000 GB/T 5782-2000 GB/T 6170-2000 GB/T 93-1987 GB/T 5782-2000 Q235 半粗羊毛毡 焊接件 GB/T 117-2000 GB/T 5782-2000 GB/T 5782-2000 GB/T 93-1987 组合件 Q235 Q235 4×∅21 2.88kW 480r/min 0.98 3.852 2 3.852 七级精度 ∅25 r6 ∅72 H7h8 ∅35 k6 ∅35 r6 ∅45 k6 ∅85 H7h8 ∅58 H7r6 安宇欣
