Explore-Space/CAD_000/打印/A3_大齿轮.pdf

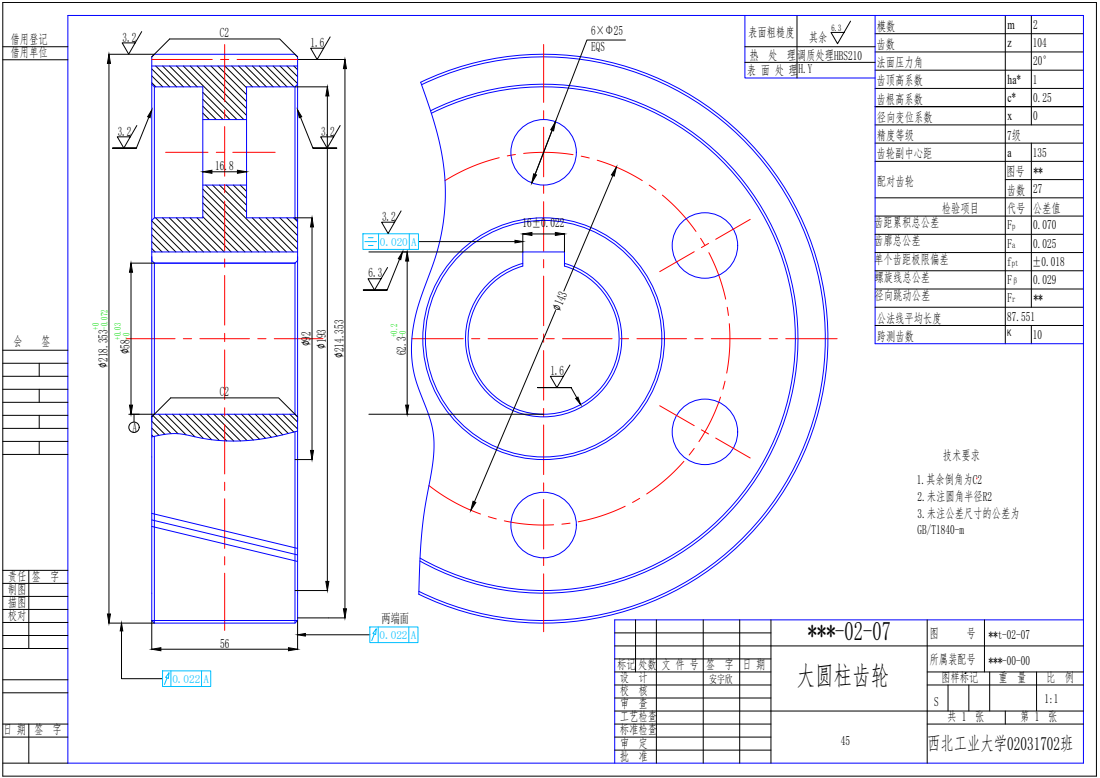
[picture p26: page 1]
z 法面压力角 齿顶高系数; ha* 齿根高系数; c* 径向变位系数; x 精度等级 齿轮副中心距; a 配对齿轮; 代号图号齿数 检验项目; 公差值 Fr 公法线平均长度 跨测齿数; KFβfpt Fa Fp; 2 7级 H.Y 表面粗糙度 热 处 理 表 面 处 理; 其余 调质处理HBS210 45 大圆柱齿轮 6.3 借用登记 借用单位 日 期; 签 字 签 字 校对制图描图责任会; 处数 工艺检查 标准检查 审 查 审 定 批 准 设 计 校 核 标记; 西北工业大学02031702班 S 共; 张 1 所属装配号 图样标记; **t-02-07 ***-00-00 ***-02-07齿距累积总公差 齿廓总公差 单个齿距极限偏差 螺旋线总公差 径向跳动公差 技术要求 1.其余倒角为C2 2.未注圆角半径R2 3.未注公差尺寸的公差为 GB/T1840-m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
