Explore-Space/CAD_000/打印/A3_输出轴.pdf

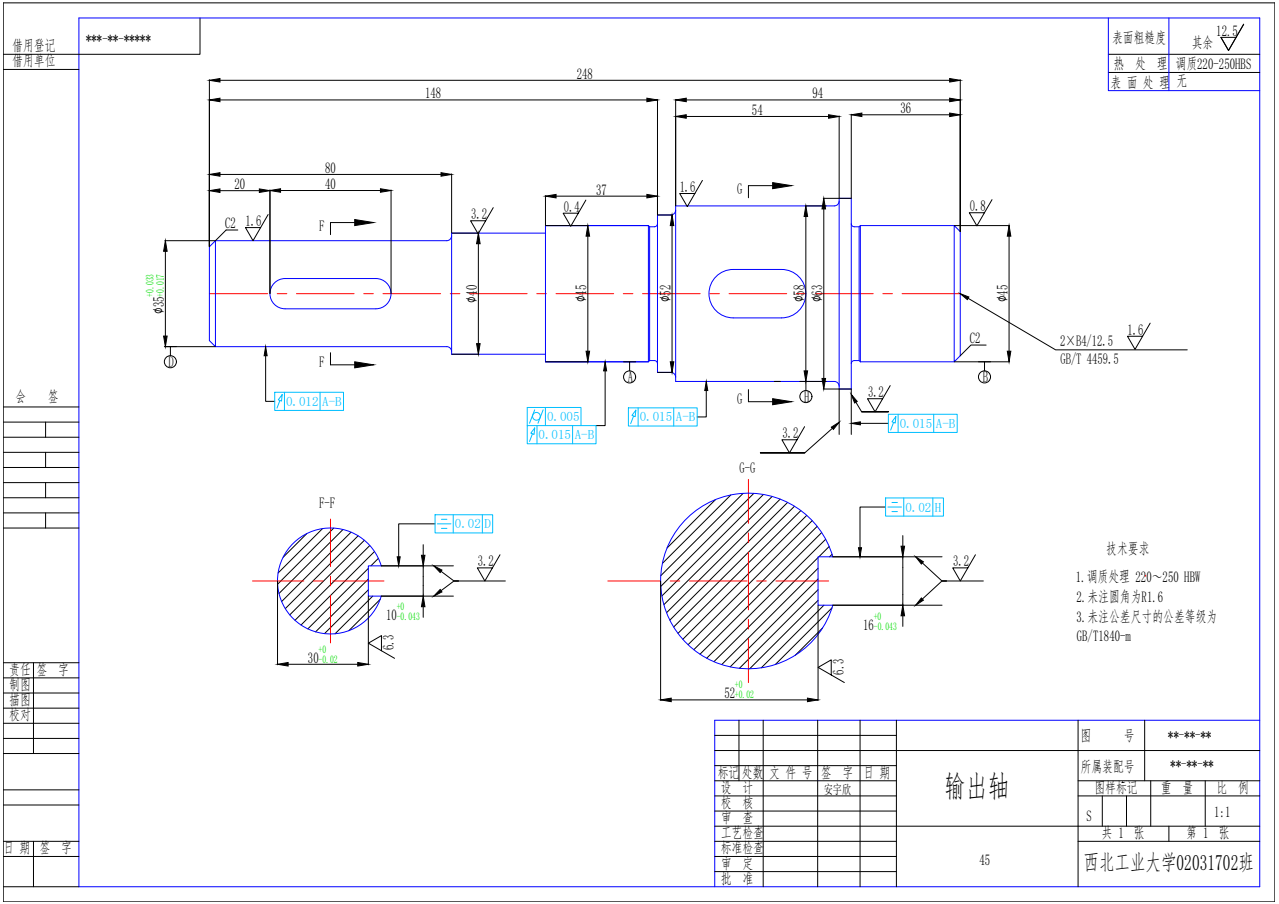
[picture p27: page 1]
借用登记 借用单位 日 期; 签 字 签 字 校对制图描图责任会; 处数 工艺检查 标准检查 审 查 审 定 批 准 设 计 校 核 标记; 张 1 所属装配号 图样标记; 调质220-250HBS 12.5 其余 表 面 处 理 热 处 理 表面粗糙度; 输出轴 安宇欣; 安宇欣 248

+0.017 ∅40 ∅45 ∅52 ∅58 ∅45 ∅63 西北工业大学02031702班 A B H D C2 1.6 3.2 0.4 1.6 0.8 G F G F 1.6 2×B4/12.5 GB/T 4459.5 0.012 A-B 0.005 0.015 A-B 0.015 A-B 3.2 3.2 0.015 A-B 0.02 H 0.02 D 技术要求 1.调质处理 220～250 HBW 2.未注圆角为R1.6 3.未注公差尺寸的公差等级为 GB/T1840-m F-F G-G 45 C2
