Explore-Space/CAD_000/(commit log)

2020-09-28 装配图
    2020.09.28-10:48
    [装配图A1.dwg]
2020-09-28 装配图
    2020.09.28-11:27
    [装配图A1.dwg]
2020-09-28 装配图
    输入轴齿轮初步轮廓
    [装配图A1.dwg]
2020-09-28 甩油环完成
    [装配图A1.dwg]
2020-09-28 输入轴完善
    [装配图A1.dwg]
2020-09-28 输入轴大致完成
    [装配图A1.dwg]
2020-09-29 轴承初步（存在错误）
    [装配图A1.dwg]
2020-09-29 轴承完成(尺寸错误已修正)
    [装配图A1.dwg]
2020-10-08 装配图完善
    [装配图A1.dwg]
2020-10-09 装配图完善（侧视图未完成+附件未完成）
    [装配图A1.dwg]
2020-10-11 部分剖面图
    [装配图A1.dwg]
2020-10-12 完善装配图
    [装配图A1.dwg]
2020-10-12 装配图剖面完善
    [装配图A1.dwg]
2020-10-13 重新归档
    [装配图A1.dwg]
2020-10-13 添加零件图模板
    [大齿轮.dwg, 输出轴.dwg]
2020-10-13 完善READEME
2020-10-13 完善设计说明书
2020-10-13 归档完善
    [大齿轮_A3.dwg, 装配图A1.dwg, 装配图_A1.dwg, 输出轴_A3.dwg]
2020-10-13 完善README
2020-10-14 零件图草图
    [大齿轮_A3.dwg, 装配图_A1.dwg, 输出轴_A3.dwg]
2020-10-19 装配图完成(缩放前备份)
    [装配图_A1.dwg]
2020-10-19 初步标注
    [装配图_A1.dwg]
2020-10-20 标注完善
    [装配图_A1.dwg]
2020-10-20 继续标注
    [装配图_A1.dwg]
2020-10-20 完善装配图标注
    [装配图_A1.dwg]
2020-10-21 装配图完成(大致检查)
    [装配图_A1.dwg]
2020-10-21 增加装配图打印
    [装配图_A1.dwg]
2020-10-21 零件图标注草图
    [大齿轮_A3.dwg, 输出轴_A3.dwg]
2020-10-23 整体完成(未归档)
    [大齿轮_A3.dwg, 装配图_A1.dwg, 输出轴_A3.dwg]
